Jishnusyam/B-Tech-Project-19EE01030-/Supported Circuit Schematics/Synchronous Converter/Circuit Diagram.jpg

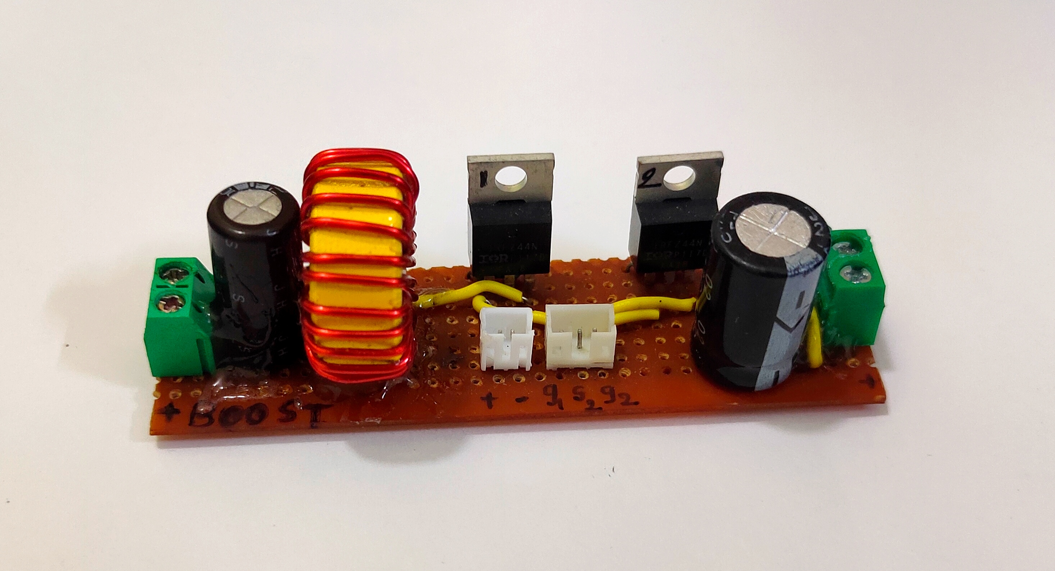
Supported Circuit Schematics/Synchronous Converter/Circuit Diagram.jpg
