Jishnusyam/B-Tech-Project-19EE01030-/README.md

# B-Tech-Project-19EE01030
on Ultrasonic Animal Deterrence System: A
Sustainable Solution for Reducing Wildlife
Casualties and Crop Losses

Ultra sonic Test on animals : https://www.youtube.com/watch?v=_Kgu1dhLU2Y
