Jishnusyam/B-Tech-Project-19EE01030-/Supported Circuit Schematics/Synchronous Converter/Buck converter/Readme.txt

* this Bootstrapping Circuit Does'nt work refer Documentation for clear Understanding
