Jishnusyam/B-Tech-Project-19EE01030-/PCB Design/Schematic_BTP.png

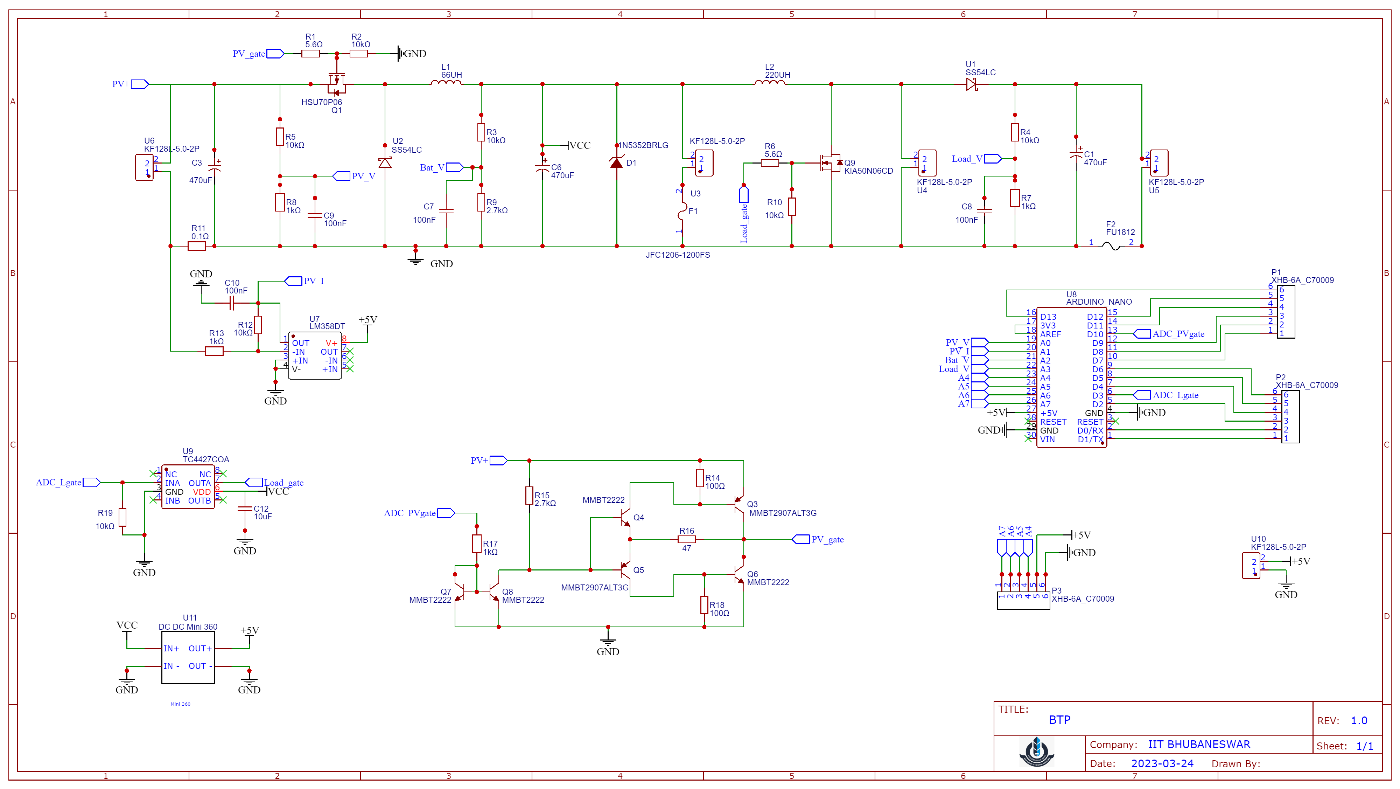
PCB Design/Schematic_BTP.png
