Jishnusyam/B-Tech-Project-19EE01030-/Supported Circuit Schematics/BJT Bases Buck Converter.png

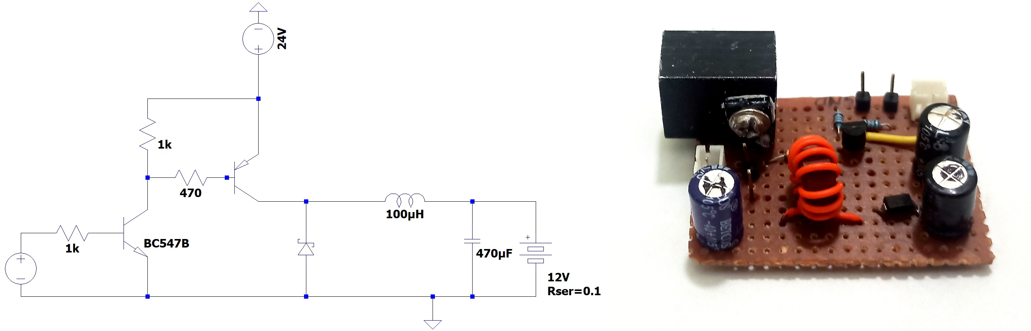
Supported Circuit Schematics/BJT Bases Buck Converter.png
