Jishnusyam/B-Tech-Project-19EE01030-/Supported Circuit Schematics/MPPT Buck converter p channel/Gate driver for P channel mosfet/Schematic.png

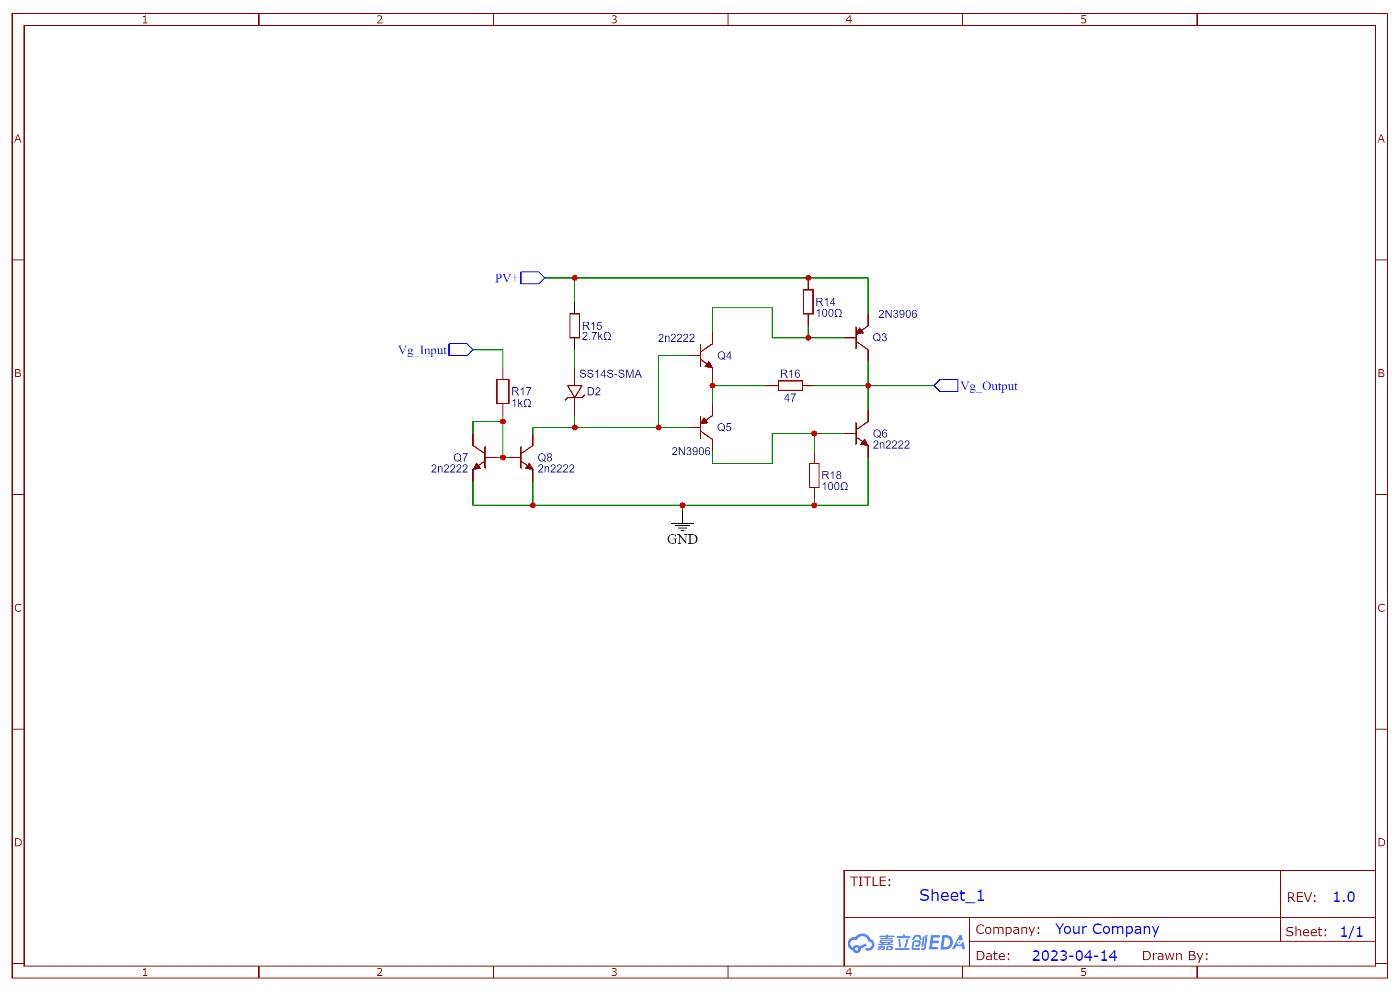
Supported Circuit Schematics/MPPT Buck converter p channel/Gate driver for P channel mosfet/Schematic.png
