Jishnusyam/B-Tech-Project-19EE01030-/Supported Circuit Schematics/MPPT Buck converter p channel/Schematic.png

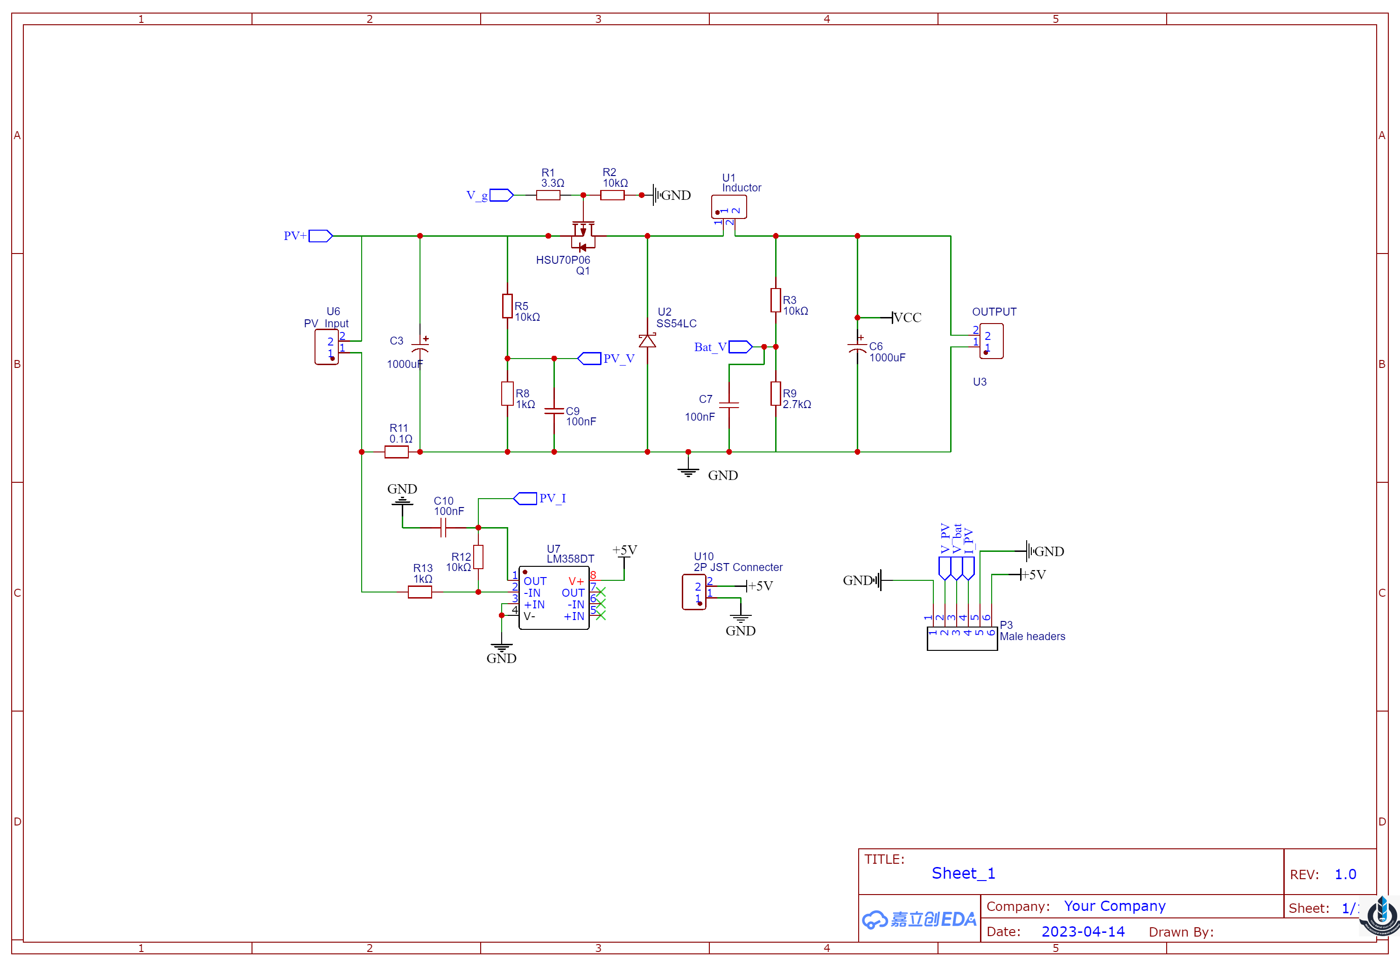
Supported Circuit Schematics/MPPT Buck converter p channel/Schematic.png
