Jishnusyam/B-Tech-Project-19EE01030-/Supported Circuit Schematics/Synchronous Converter/Boost converter/V_DS of Boost converter.jpeg

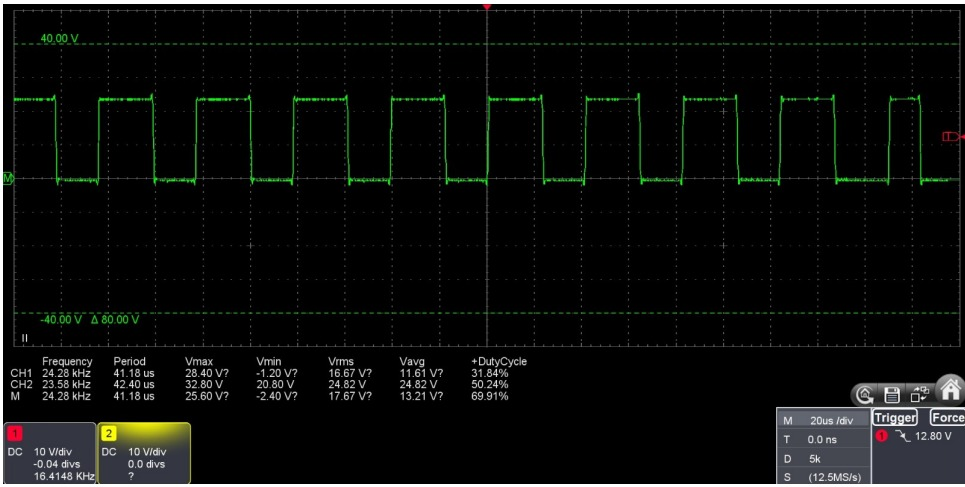
Supported Circuit Schematics/Synchronous Converter/Boost converter/V_DS of Boost converter.jpeg
