Jishnusyam/B-Tech-Project-19EE01030-/Supported Circuit Schematics/Synchronous Converter/Circuit Schematic.png

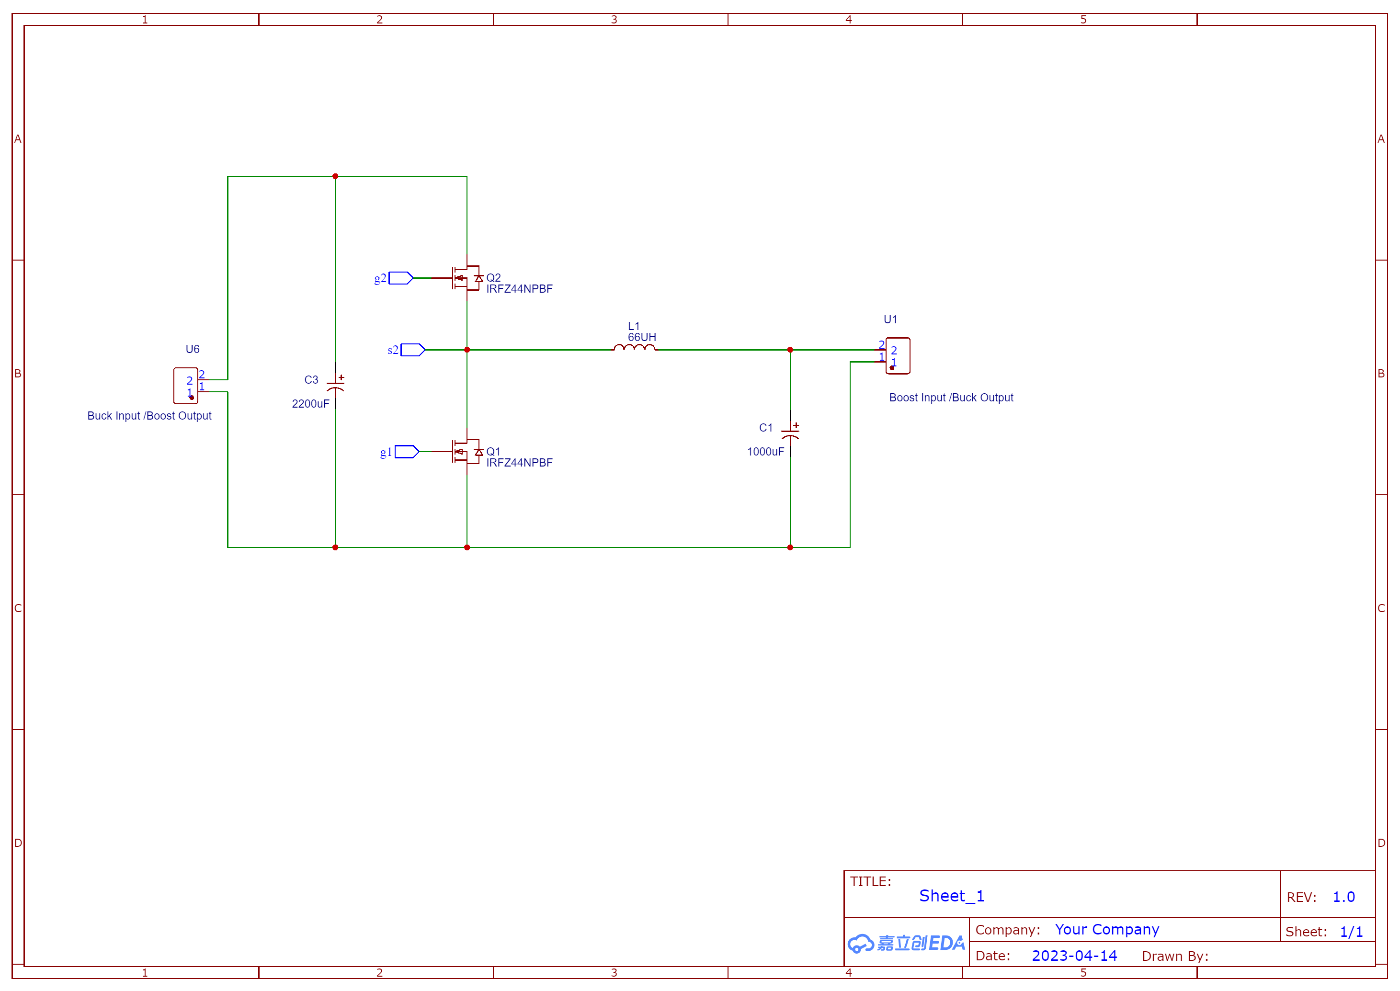
Supported Circuit Schematics/Synchronous Converter/Circuit Schematic.png
