Jishnusyam/B-Tech-Project-19EE01030-/Supported Circuit Schematics/Synchronous Converter/Boost converter/Setup Schematic.jpeg

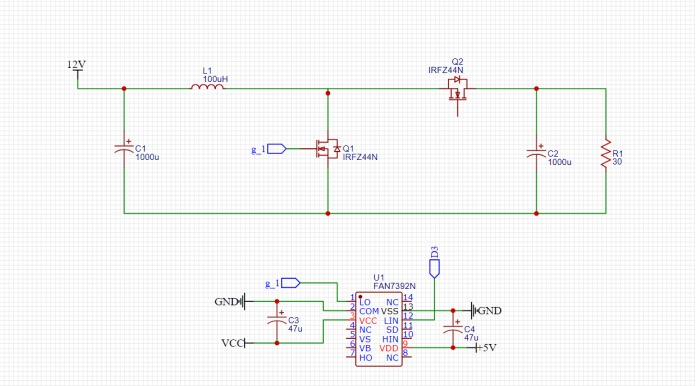
Supported Circuit Schematics/Synchronous Converter/Boost converter/Setup Schematic.jpeg
