Jishnusyam/B-Tech-Project-19EE01030-/Supported Circuit Schematics/MPPT Buck converter p channel/Results/2.arduino data.jpeg

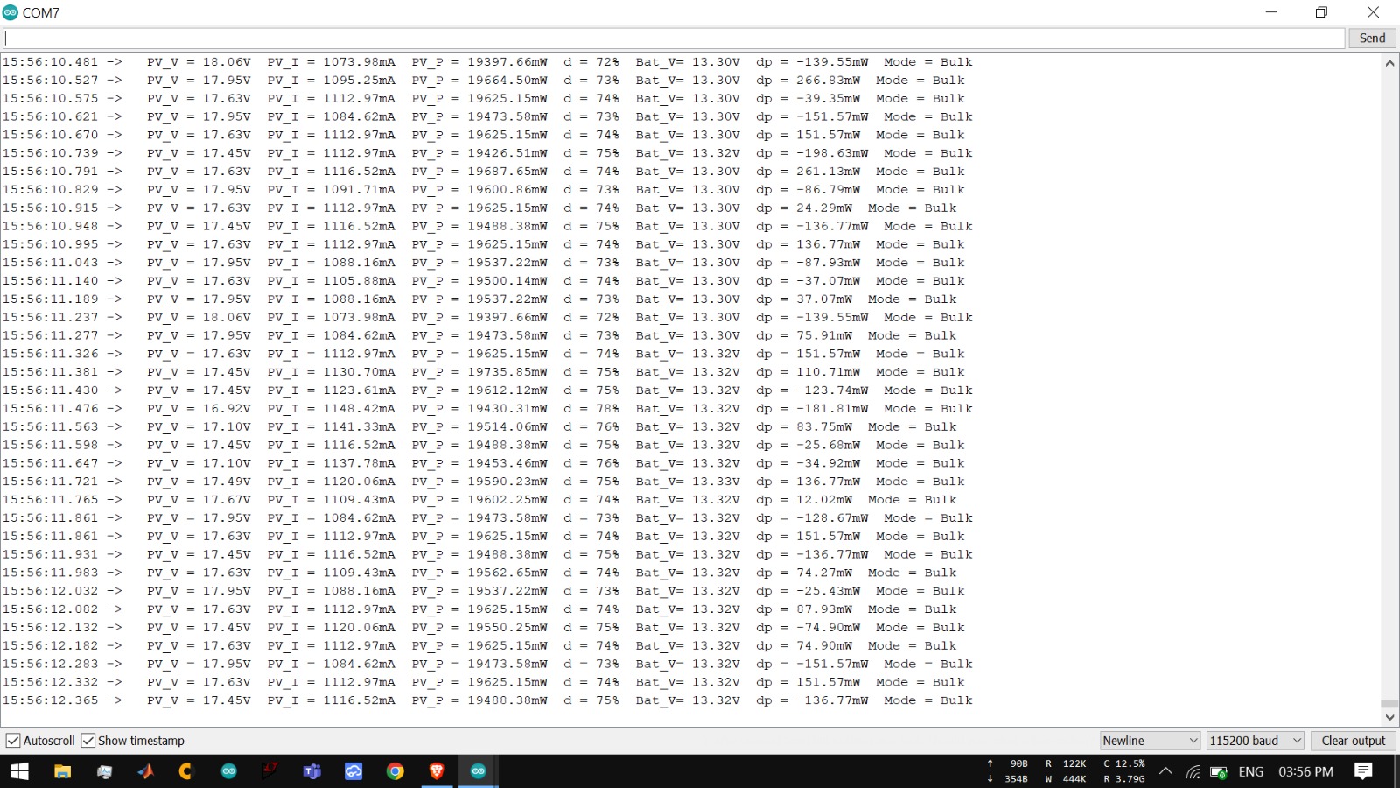
Supported Circuit Schematics/MPPT Buck converter p channel/Results/2.arduino data.jpeg
