Jishnusyam/B-Tech-Project-19EE01030-/Supported Circuit Schematics/MPPT Buck converter p channel/Results/3.mppt tracker.jpeg

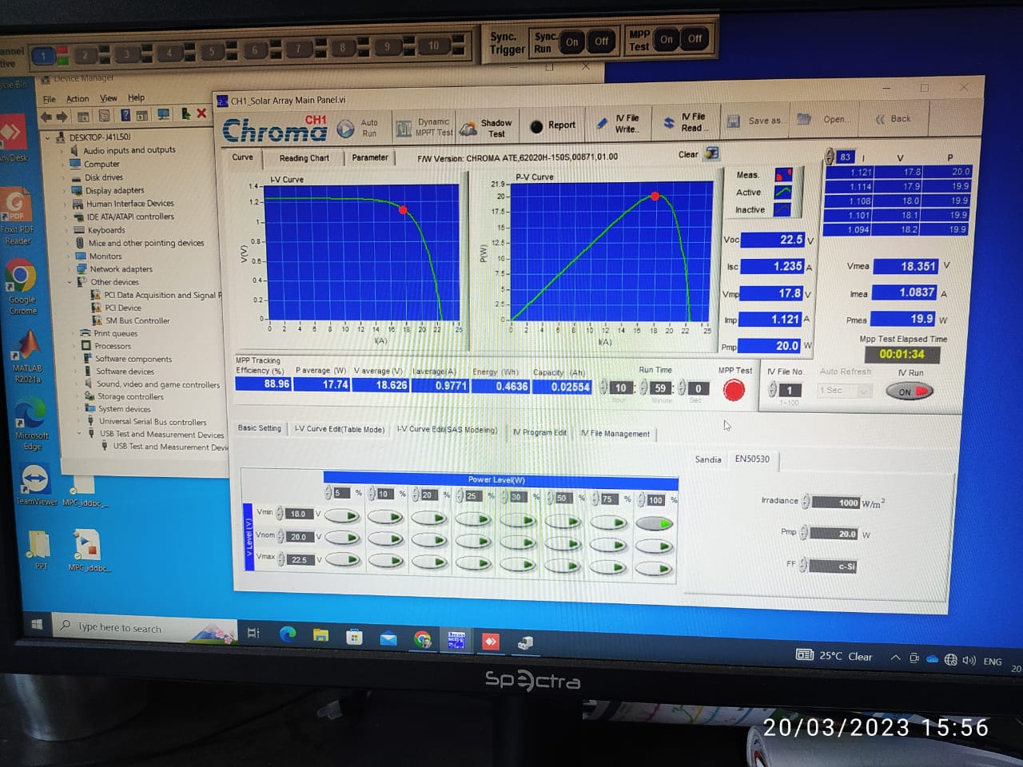
Supported Circuit Schematics/MPPT Buck converter p channel/Results/3.mppt tracker.jpeg
