Jishnusyam/B-Tech-Project-19EE01030-/Supported Circuit Schematics/MPPT Buck converter p channel/Results/V_Gate & V_Source(channel-2).jpeg

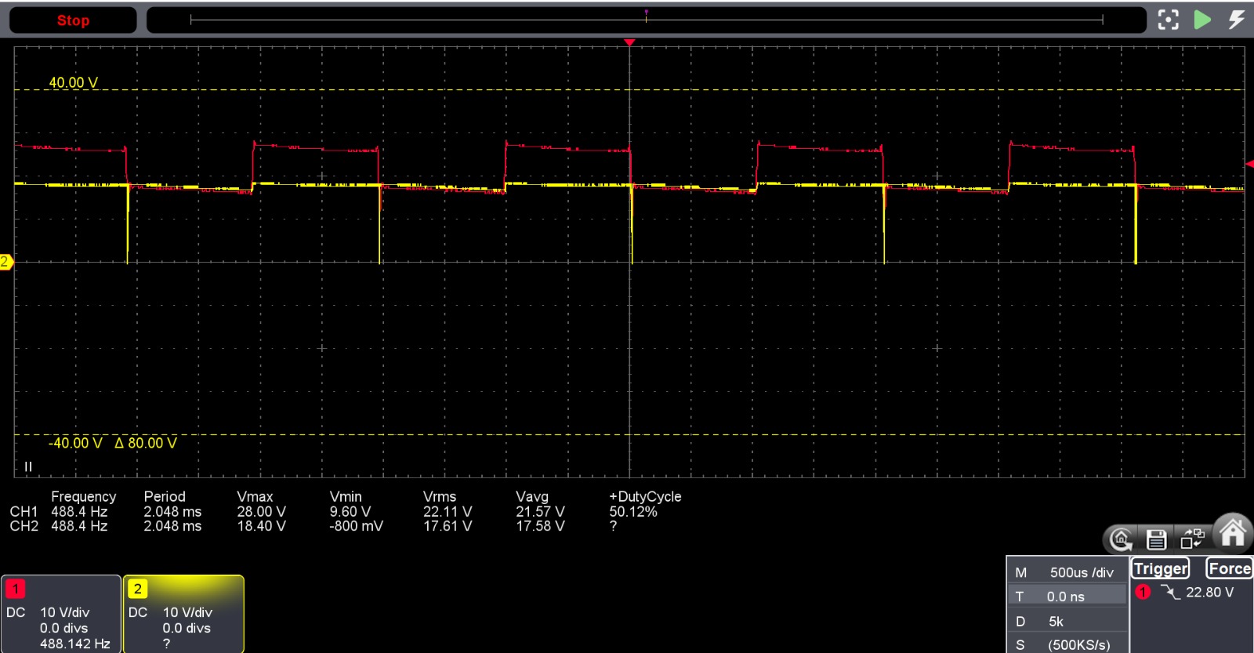
Supported Circuit Schematics/MPPT Buck converter p channel/Results/V_Gate & V_Source(channel-2).jpeg
