Jishnusyam/B-Tech-Project-19EE01030-/Supported Circuit Schematics/MPPT Buck converter p channel/Results/V_GS.jpeg

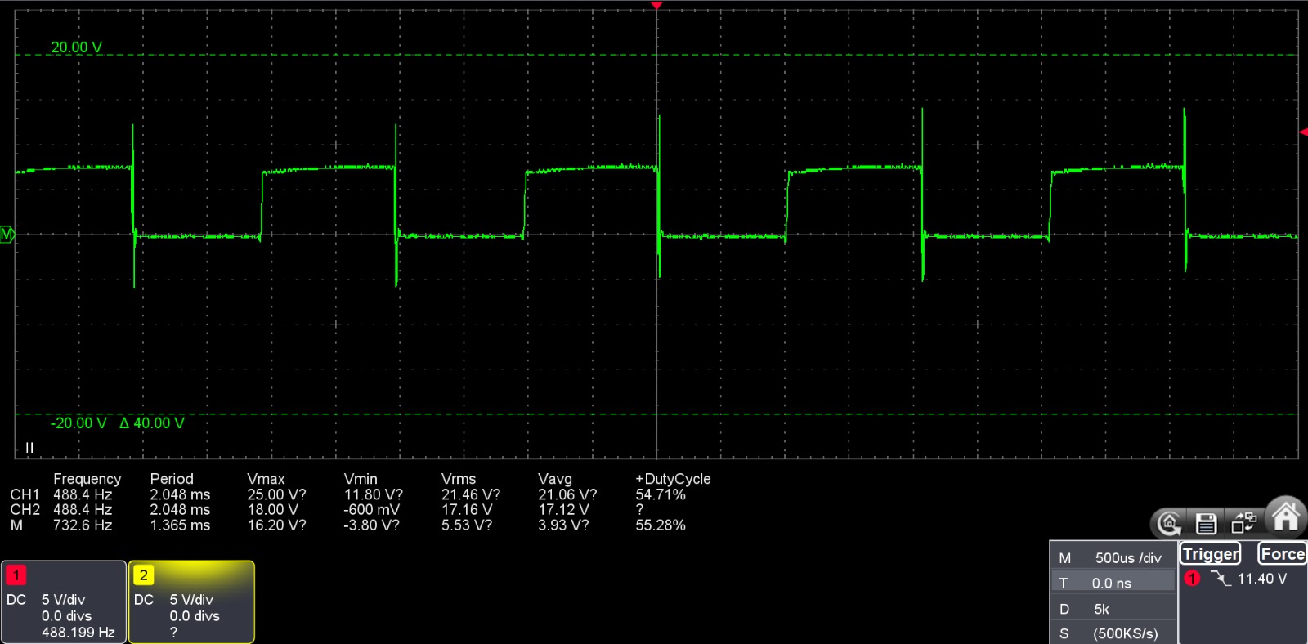
Supported Circuit Schematics/MPPT Buck converter p channel/Results/V_GS.jpeg
