Jishnusyam/B-Tech-Project-19EE01030-/Simulations/LT Spice/current_Measurements.asc

I1: current; 1A
R1: res; 1K
R2: res; 10k
R3: res; 0.1
U1: OP747
V1: voltage; 5v
Named nets: Vin, Vout, 0, 5V
.tran 100
