Jishnusyam/B-Tech-Project-19EE01030-/Simulations/LT Spice/Buck converter Design By/P Channel MOSFET and Gate Driver.asc

C2: cap; 1000µF
D3: schottky; RBR5LAM60A
L1: ind; 100µ
M1: pmos; Si7461DP
Q1: npn; BC547C
Q2: pnp
Q3: npn; BC547C
Q4: npn; BC547C
Q5: npn; BC547C
Q6: pnp
R1: res; 2.7K
R2: res; 1k
R3: res; 47
R4: res; 100
R5: res; 100
V1: battery; 12V; Rser=0.1
V2: voltage; 33
V4: voltage; PULSE(0 5v 1n 1n 1n 1u 3u)
Named nets: 0
.tran 10m
