Jishnusyam/B-Tech-Project-19EE01030-/Simulations/LT Spice/Buck converter Design By/Bootstrapping.asc

12V: battery; ""; Rser=0.05
C1: cap; 1µF
D1: diode; 1N4148
D2: schottky; SS3P5
L1: ind; 100µ
M1: nmos; IRFZ44N
PV: voltage; 24
R1: res; 10
U1: 
V3: voltage; 5V
V4: voltage; V_Gate
Named nets: 0, V_Bat
.tran 10m
.inc FAN7392_REV1p2_ltspice.txt
