Jishnusyam/B-Tech-Project-19EE01030-/Simulations/LT Spice/Buck converter Design By/Gate drive transformer.asc

C1: cap; 10µ
D2: schottky; SS3P5
L1: ind2; 100µ
L2: ind2; 100µH
L3: ind2; 100µH
M1: nmos; IRFZ44N
PV: voltage; 24
R1: res; 10k
R2: res; 10
R3: res; 10
U1: 
V1: battery; 12V; Rser=0.1
V3: voltage; 5V
V4: voltage; PULSE(0 12 1n 1n 1n 11u 16u)
Named nets: 0, V_Bat
.tran 10m
.inc FAN7392_REV1p2_ltspice.txt
V_Gate
K L2 L3 1
