Jishnusyam/B-Tech-Project-19EE01030-/Simulations/LT Spice/Buck converter Design By/Isolated Battery (modified).asc

C1: cap; 10µF
C2: cap; 470µF
C4: cap; 100n
D1: diode; 1N4148
D2: schottky; RBR3LAM30A
D3: diode; 1N4148
L1: ind; 50µ
M1: nmos; IRFZ44N
M2: nmos; IRFZ44N
R1: res; 100
R2: res; 10k
R6: res; 10k
U1: 
U3: OP07
V1: battery; 12; Rser=0.1
V2: voltage; 24
V3: voltage; 5V
V4: voltage; PULSE(0 5v 1n 1n 1n 10.5u 20u)
Named nets: 0, V_bat
.inc FAN7392_REV1p2_ltspice.txt
.tran 10m
V_Gate
