Jishnusyam/B-Tech-Project-19EE01030-/Simulations/LT Spice/Buck converter Design By/isolated power supply.asc

C2: cap; 470µ
D2: schottky; RBR5LAM60A
L1: ind; 100µ
M1: nmos; IRFZ44N
PV: voltage; 24
R2: res; 4
U1: 
V1: battery; 12; Rser=0.2
V3: voltage; 5V
V4: voltage; PULSE(0 5v 1n 1n 1n 13u 20u)
V5: voltage; 12V
Named nets: 0, V_bat, V_g
.inc FAN7392_REV1p2_ltspice.txt
.tran 10m
Isolated Power Supply
V_Gate
