Jishnusyam/B-Tech-Project-19EE01030-/Simulations/LT Spice/Buck converter Design By/Linear voltage regulator.asc

C1: cap; 1µF
C2: cap; 1000µ
C3: cap; 10µF
C4: cap; 10µF
C5: cap; 10µF
D1: schottky; BAT54
D2: schottky; RBR3MM30A
D3: schottky; MBRS130L
D4: schottky; 1N5819
L1: ind; 100µ
M1: nmos; IRFZ44N
R1: res; 3.7
R2: res; 30
R3: res; 400
U1: 
U2: LT1086H
V1: battery; 13.5V; Rser=0.1
V3: voltage; 5V
V4: voltage; PULSE(0 5v 1n 1n 1n 11.5u 20u)
V_PV: voltage; 24
Named nets: 0, V_bat, V_reg
.tran 100m
.inc FAN7392_REV1p2_ltspice.txt
V_Gate
