Jishnusyam/B-Tech-Project-19EE01030-/Simulations/LT Spice/Buck converter Design By/PNP.asc

C1: cap; 470µF
D1: schottky; MBRS340
L1: ind; 100µH
Q1: pnp; 2SAR562F3
Q2: npn; BC547B
R1: res; 1k
R2: res; 470
R3: res; 1k
V1: voltage; 24V
V2: battery; 12V; Rser=0.1
V3: voltage; PULSE(0 5V 1n 1n 1n 13us 20us)
Named nets: 0
.tran 1m
