Jishnusyam/B-Tech-Project-19EE01030-/Simulations/LT Spice/Buck converter Design By/boost.asc

C1: cap; 200nF
C2: cap; 470µF
D2: schottky; RBR5LAM60A
L1: ind; 50µ
M1: nmos; IRFZ44N
R1: res; 10
R2: res; 5
R3: res; 30
V2: voltage; 12
V4: voltage; PULSE(0 5 1n 1n 1n 30u 100u)
Named nets: 0, V_bat
.tran 10m
