Jishnusyam/B-Tech-Project-19EE01030-/Simulations/LT Spice/Buck converter Design By/Isolated battery.asc

C1: cap; 1µF
C2: cap; 100µF
C3: cap; 100µF
D1: diode; 1N4148
D2: schottky; SS3P5
L1: ind; 100µ
M1: nmos; IRFZ44N
Q1: npn; BC547B
Q2: npn; 2N3055
R1: res; 3.7
R2: res; 10k
R3: res; 100
R4: res; 1k
R5: res; 100
U1: 
V1: battery; 12; Rser=0.1
V2: voltage; 19
V3: voltage; 5V
V4: voltage; PULSE(0 5v 1n 1n 1n 13.5u 20u)
V6: voltage; PULSE(5 0 1m 1n 1n 100m 1)
Named nets: 0, V_bat
.tran 10m
.inc FAN7392_REV1p2_ltspice.txt
