Jishnusyam/B-Tech-Project-19EE01030-/Simulations/LT Spice/Buck converter Design By/modified_Bootstrapping.asc

C1: cap; 1µF
C2: cap; 470µ
D1: diode; 1N4148
D2: schottky; SS3P5
D3: diode
D4: diode
L1: ind; 100µ
M1: nmos; IRFZ44N
R1: res; 3.7
U1: 
V1: battery; 12V; Rser=0.1
V2: voltage; 19
V3: voltage; 5V
V4: voltage; PULSE(0 5v 1n 1n 1n 13u 20u)
Named nets: 0, V_PV, V_bat
.tran 10m
.inc FAN7392_REV1p2_ltspice.txt
