Jishnusyam/B-Tech-Project-19EE01030-/Simulations/LT Spice/Buck converter Design By/pmosfet with optocoupler.asc

C1: cap; 1000µF
D2: zener; EDZV9_1B
D3: schottky; RBR5LAM60A
L1: ind; 33µ
M1: pmos; Si7461DP
Q1: npn; 2N2222
Q2: pnp; 2N2907
Q3: npn; 2N2222
R1: res; 1k
R3: res; 1k
R4: res; 1k
R5: res; 100
U1: PC817A
V1: battery; 12V; Rser=0.1
V2: voltage; 24
V3: voltage; PULSE(5v 0v 1n 1n 1n 15u 30u)
Named nets: 0
10V
.tran 10m
