Jishnusyam/B-Tech-Project-19EE01030-/Simulations/LT Spice/Buck converter Design By/PMOSFET.asc

C2: cap; 470µ
D2: schottky; MBR745
L1: ind; 100µ
M1: pmos; Si7469DP
R1: res; 4.7
U1: 
V1: battery; 12; Rser=0.1
V2: voltage; 19
V3: voltage; 5V
V4: voltage; PULSE(0v 5v 1n 1n 1n 7u 20u)
Named nets: 0
.tran 10m
.inc FAN7392_REV1p2_ltspice.txt
