Jishnusyam/B-Tech-Project-19EE01030-/(list of files, drawings)

Other design files:
PCB Design/SCH_BTP_final_4_2023-04-10.json
PCB Design/Sheet_1_2023-04-10.schdoc
